stevenbags/ECE-411-Group-12/Group 12.brd

## EAGLE design Group 12.brd (2017-11-16)

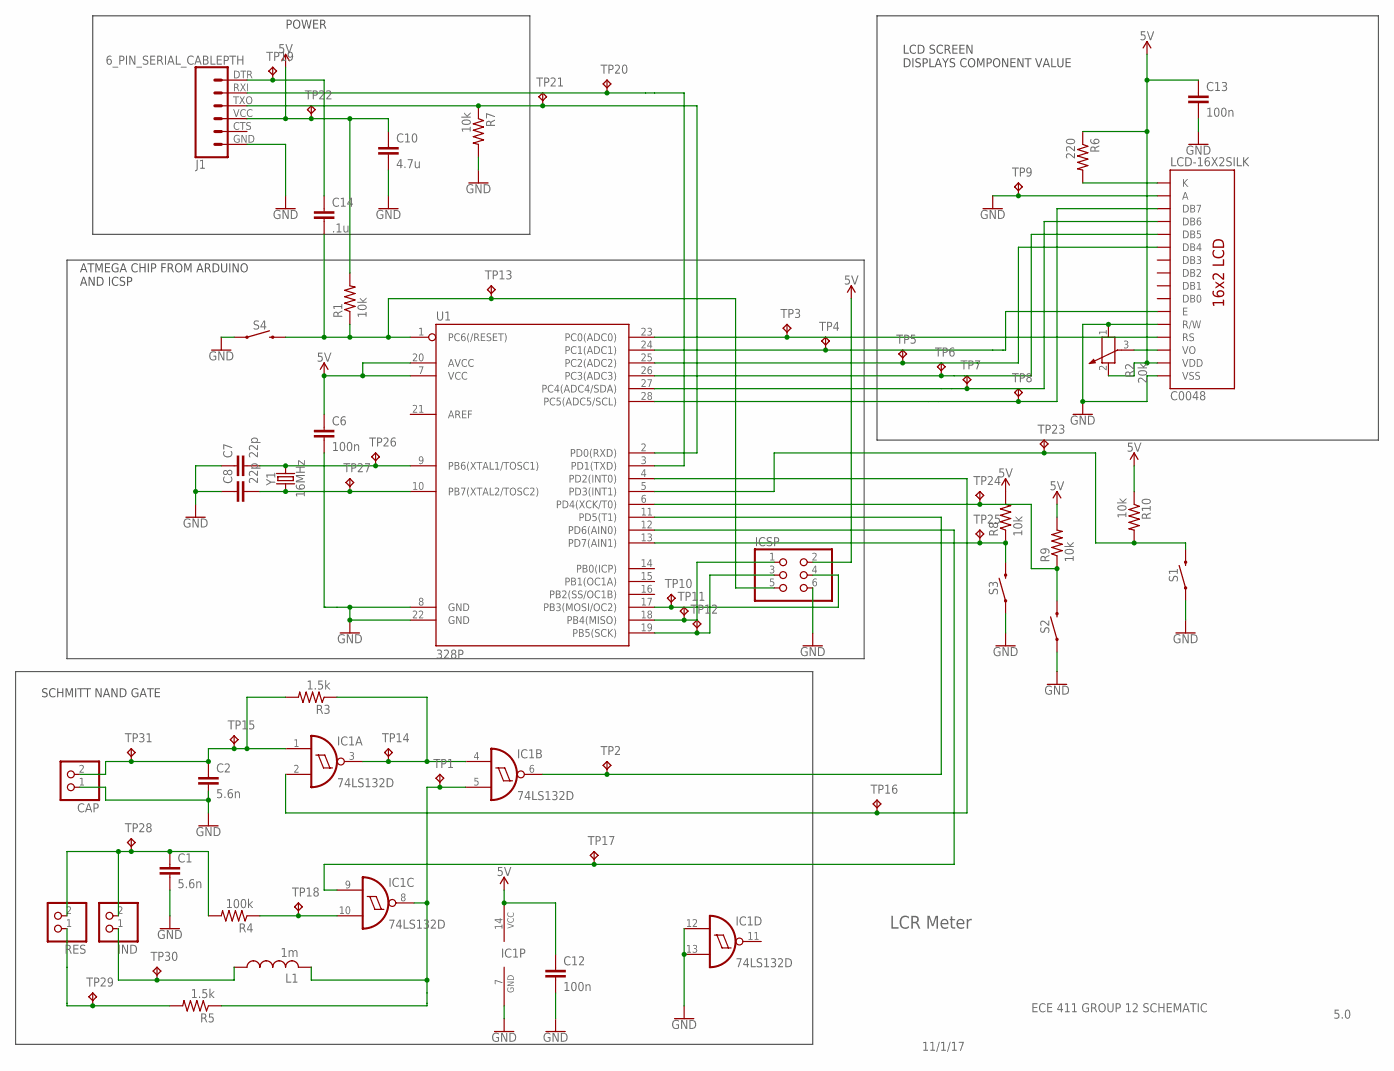
[picture p3: schematic Group 12.sch]

Parts:
C1, C2: 5.6n; C0805K
C6, C12, C13: 100n; C0805K
C7, C8: 22p; C0805K
C10: 4.7u; C0805K
C14: .1u; C0805K
C0048: LCD-16X2SILK; LCD-16X2
CAP: PINHD-1X2; 1X02
IC1: 74LS132D; SO14
ICSP: PINHD-2X3; 2X03
IND: PINHD-1X2; 1X02
J1: 6_PIN_SERIAL_CABLEPTH; FTDI_BASIC
L1: 1m; 0204/5
R1, R7, R8, R9, R10: 10k; R0805
R2: 20k; PT-10
R3, R5: 1.5k; M0805
R4: 100k; M0805
R6: 220; R0805
RES: PINHD-1X2; 1X02
S1, S2, S3, S4: MOMENTARY-SWITCH-SPST-SMD-6.0X3.5MM; TACTILE_SWITCH_SMD_6.0X3.5MM
TP1, TP2, TP3, TP4, TP5, TP6, TP7, TP8, TP9, TP10, TP11, TP12, TP13, TP14, TP15, TP16, TP17, TP18, TP19, TP20, TP21, TP22, TP23, TP24, TP25, TP26, TP27, TP28, TP29, TP30, TP31: TPPAD1-13; P1-13
U1: 328P; DIP28
Y1: 16MHz; CRYSTAL-SMD-5X3.2-4PAD

Connections:
5V: C6.1, C10.1, C12.1, C13.1, C0048.2 (VDD), IC1.14 (VCC), ICSP.2, J1.VCC (4), R1.2, R2.2, R6.1, R8.2, R9.2, R10.1, TP22.TP, U1.7 (VCC), U1.20 (AVCC)
CAL: R9.1, S2.2, TP24.TP, U1.6 (PD4(XCK/T0))
GND: C1.2, C2.2, C6.2, C7.1, C8.1, C10.2, C12.2, C13.2, C0048.1 (VSS), C0048.5 (R/W), C0048.15 (A), CAP.1, IC1.7 (GND), IC1.12 (I0), IC1.13 (I1), ICSP.6, J1.GND (6), R2.1, R7.2, S1.1, S2.1, S3.1, S4.1, TP9.TP, U1.8 (GND), U1.22 (GND)
MISO: ICSP.1, TP11.TP, U1.18 (PB4(MISO))
MODE: R10.2, S1.2, TP23.TP, U1.5 (PD3(INT1))
unnamed: C2.1, CAP.2, IC1.1 (I0), R3.2, TP15.TP, TP31.TP
unnamed: IC1.10 (I1), R4.1, TP18.TP
unnamed: J1.RXI (2), TP20.TP, U1.3 (PD1(TXD))
unnamed: ICSP.4, TP10.TP, U1.17 (PB3(MOSI/OC2))
unnamed: IC1.3 (O), IC1.4 (I0), R3.1, TP14.TP
unnamed: C14.1, J1.DTR (1), TP19.TP
unnamed: R5.2, RES.1, TP29.TP
unnamed: IC1.5 (I1), IC1.8 (O), L1.2, R5.1, TP1.TP
unnamed: IND.1, L1.1, TP30.TP
unnamed: C1.1, IND.2, R4.2, RES.2, TP28.TP
unnamed: C0048.3 (VO), R2.3
unnamed: C0048.16 (K), R6.2
PB6: C7.2, TP26.TP, U1.9 (PB6(XTAL1/TOSC1)), Y1.3 (2)
PB7: C8.2, TP27.TP, U1.10 (PB7(XTAL2/TOSC2)), Y1.1
PC0: C0048.4 (RS), TP3.TP, U1.23 (PC0(ADC0))
PC1: C0048.6 (E), TP4.TP, U1.24 (PC1(ADC1))
PC2: C0048.11 (DB4), TP5.TP, U1.25 (PC2(ADC2))
PC3: C0048.12 (DB5), TP6.TP, U1.26 (PC3(ADC3))
PC4: C0048.13 (DB6), TP7.TP, U1.27 (PC4(ADC4/SDA))
PC5: C0048.14 (DB7), TP8.TP, U1.28 (PC5(ADC5/SCL))
PD0: J1.TXO (3), R7.1, TP21.TP, U1.2 (PD0(RXD))
PD2: IC1.2 (I1), TP16.TP, U1.4 (PD2(INT0))
PD5: IC1.6 (O), TP2.TP, U1.11 (PD5(T1))
PD6: IC1.9 (I0), TP17.TP, U1.12 (PD6(AIN0))
RESET: C14.2, ICSP.5, R1.1, S4.2, TP13.TP, U1.1 (PC6(/RESET))
SCK: ICSP.3, TP12.TP, U1.19 (PB5(SCK))
SET: R8.1, S3.2, TP25.TP, U1.13 (PD7(AIN1))

Notes on the sheet:
11/1/17
ECE 411 GROUP 12 SCHEMATIC
5.0
LCR Meter
POWER
LCD SCREEN DISPLAYS COMPONENT VALUE
ATMEGA CHIP FROM ARDUINO AND ICSP
SCHMITT NAND GATE

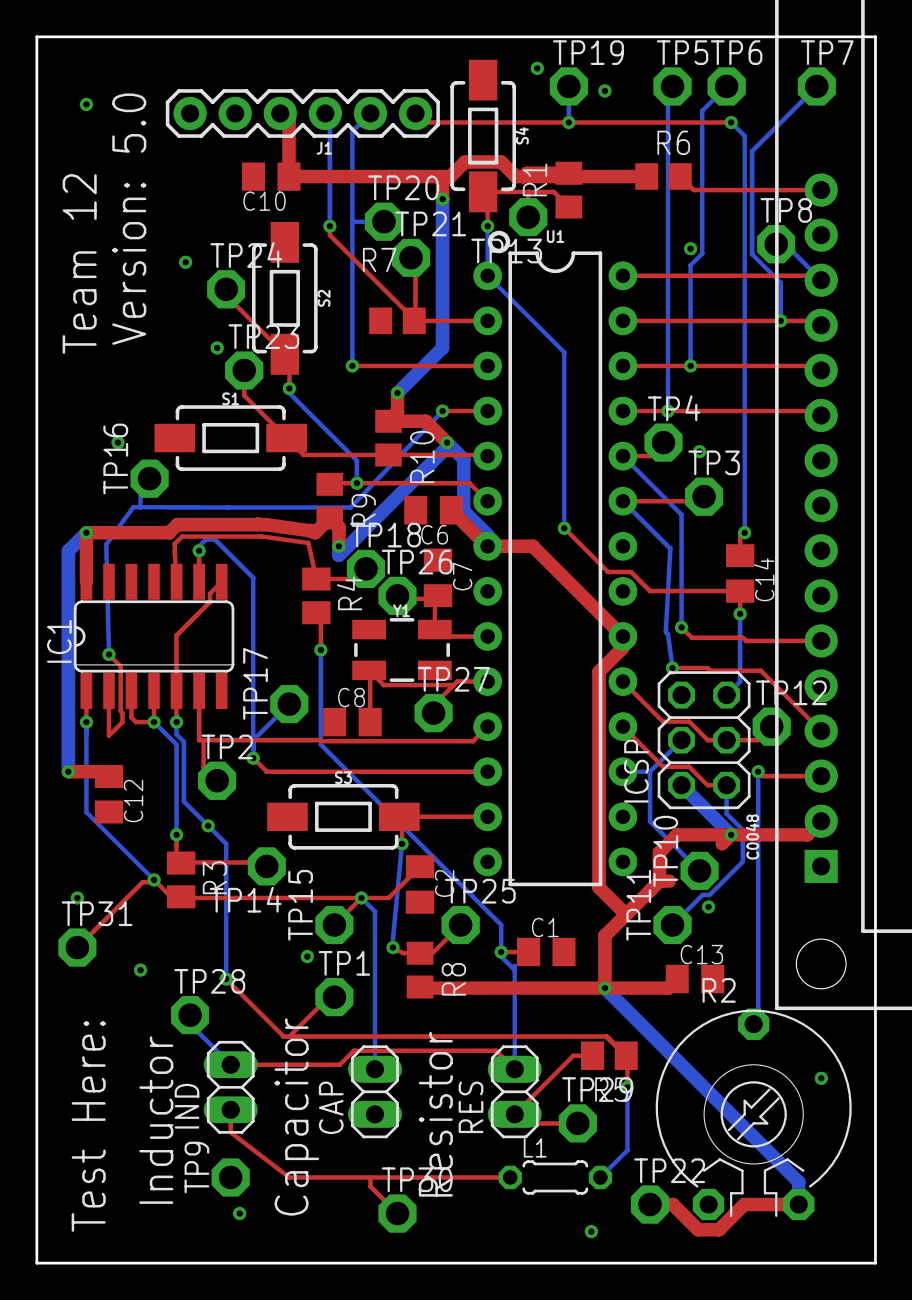
[picture p4: board Group 12.brd from above]

Board: 2 copper layers, 47.2 x 69.1 mm, 64 parts (0 on the bottom side), 32 nets.
