stevenbags/ECE-411-Group-12/(commit log)

2017-10-25 Prelim Schem
    Prelim Schem
    [Group 12.sch]
2017-11-02 Schm and Proj Sch
    Schematic and Project Schedule
    [Group 12.sch]
2017-11-02 Final Schem
    Final Schem
    [Group 12.sch]
2017-11-09 prelim layout
    prelim layout
    [Group 12.brd]
2017-11-15 board and sch
    board and sch
    [Group 12.brd, Group 12.sch]
2017-11-16 final sch and brd
    final sch and brd
    [Group 12.brd, Group 12.sch]
2017-11-16 final brd and sch
    final brd and sch
    [Group 12.brd, Group 12.sch]
